QuestNPC/MarbleThrower/readme.md

Project for Principles of Digital Fabrication

Students: Aki Korpinen, Jaakko Astikainen, Eino Niemelä, Antti Jääski
