QuestNPC/MarbleThrower/2D files/Box out small.pdf

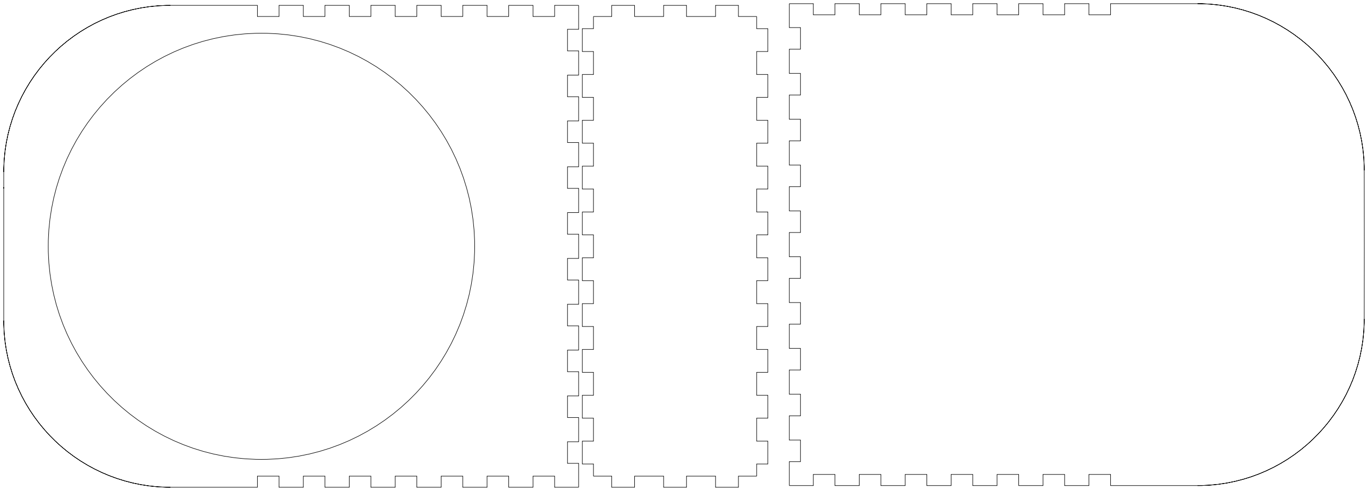
[picture p3: figure]
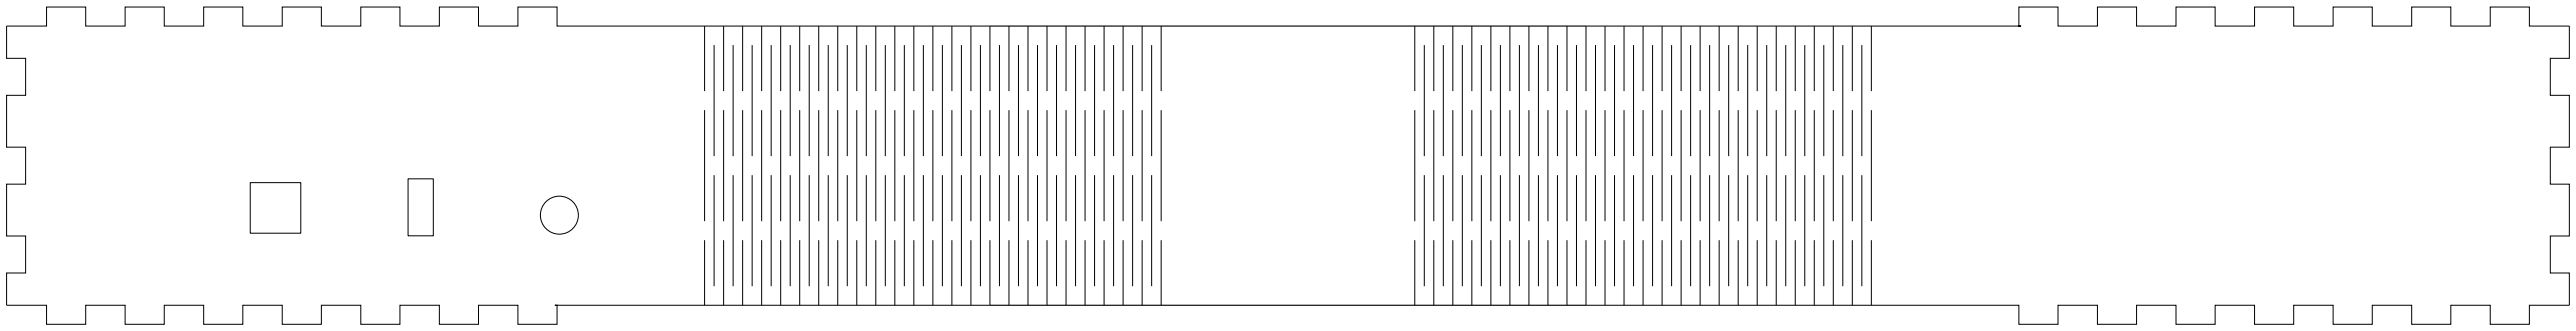
[picture p4: figure]
