QuestNPC/MarbleThrower/Documentation drafts/images/Final_overall.png

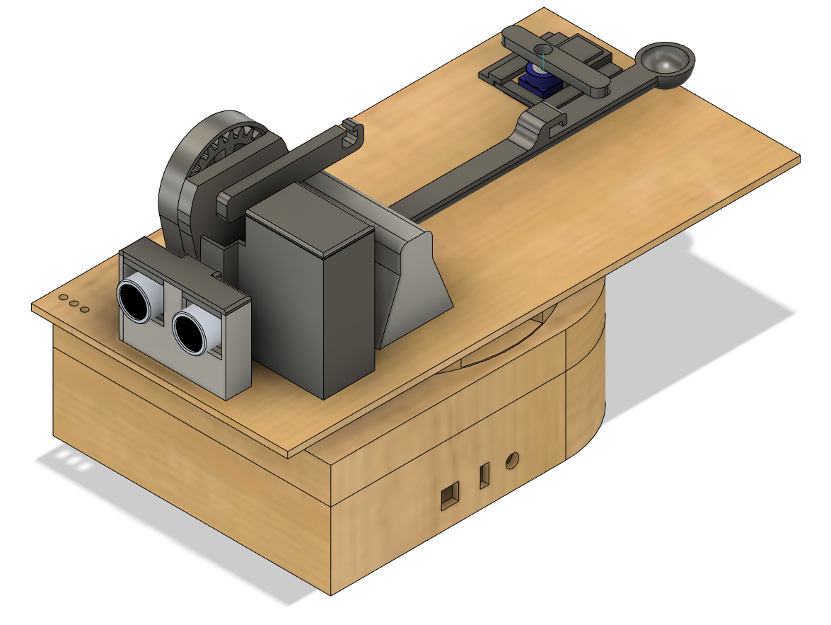
Documentation drafts/images/Final_overall.png
