QuestNPC/MarbleThrower/Documentation drafts/images/Final_side.png

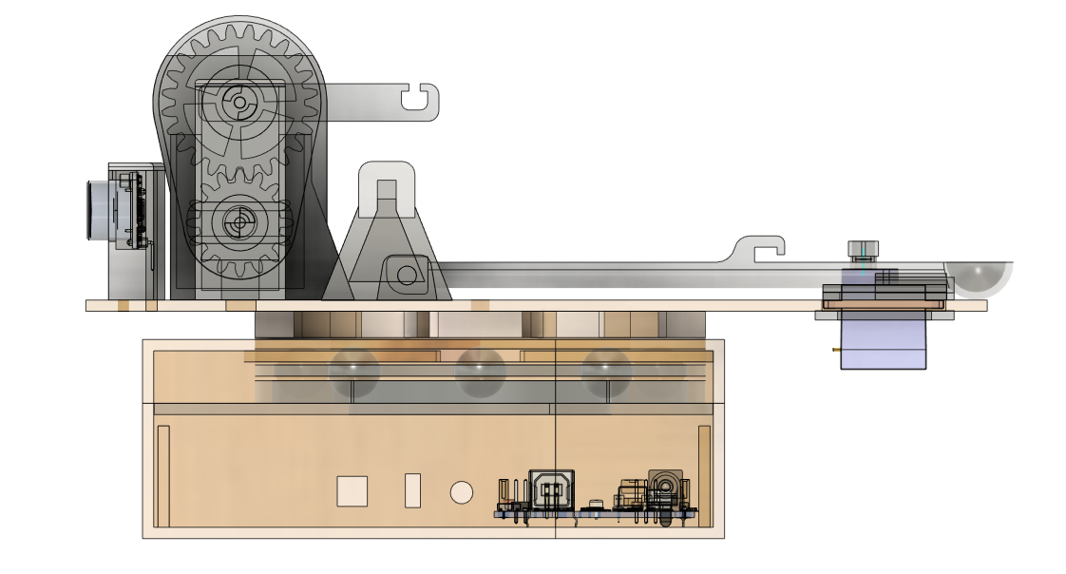
Documentation drafts/images/Final_side.png
