QuestNPC/MarbleThrower/Documentation drafts/Bill_of_Materials.md

* 1x Arduino Uno
* 1 x Ultrasonic sensor
* 2 x Micro Servo Motor SG90
* 1 x Servo motor HS-322HD
* 1 x Push micro button
* 3 x LEDs
* 1 x Potentiometer
* 1 x slide switch
* 1 x M4x40 bolt + nut
* Plywood
* marbles/glassballs (14mm diam)
