QuestNPC/MarbleThrower/3D files/Parts STL files/stopper.stl

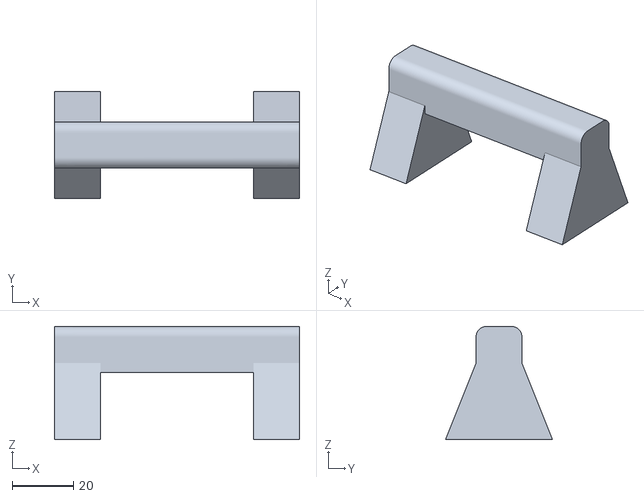
[picture p7: CAD file, 2021-05-05]
3D files/Parts STL files/stopper.stl
80.0 x 35.0 x 37.0
