QuestNPC/MarbleThrower/3D files/Parts STL files/servo-gear-connector-part2.stl

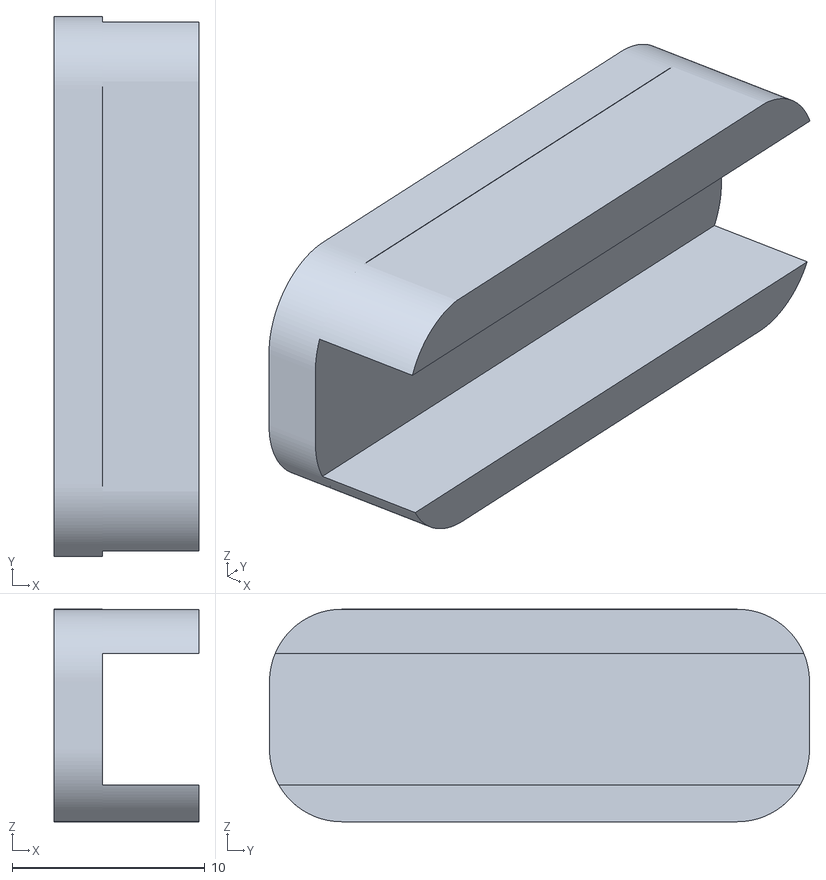
[picture p8: CAD file, 2021-05-05]
3D files/Parts STL files/servo-gear-connector-part2.stl
7.50 x 28.0 x 11.0
