QuestNPC/MarbleThrower/3D files/Parts STL files/Servo_holder_piece.stl

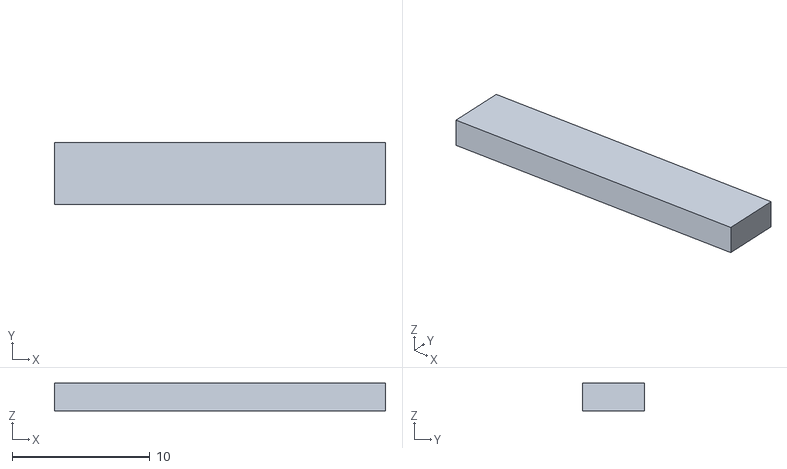
[picture p9: CAD file, 2021-05-05]
3D files/Parts STL files/Servo_holder_piece.stl
24.0 x 4.50 x 2.00
