QuestNPC/MarbleThrower/3D files/Parts STL files/Nobs.stl

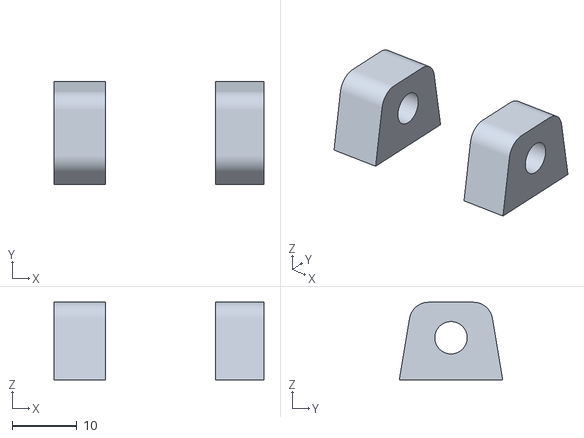
[picture p10: CAD file, 2021-05-05]
3D files/Parts STL files/Nobs.stl
32.5 x 16.0 x 12.0
