QuestNPC/MarbleThrower/3D files/Parts STL files/servo_holder_top.stl

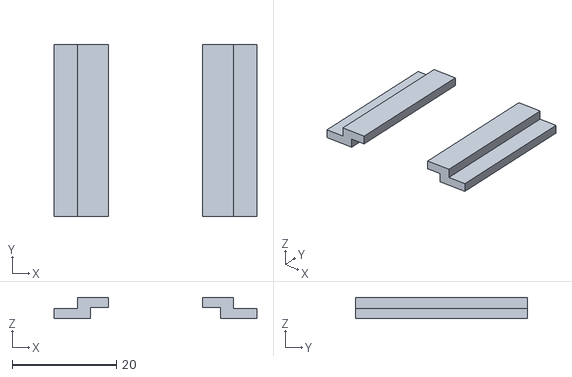
[picture p11: CAD file, 2021-05-05]
3D files/Parts STL files/servo_holder_top.stl
39.0 x 33.0 x 4.10
