QuestNPC/MarbleThrower/3D files/Parts STL files/Spur Gear (16 teeth).stl

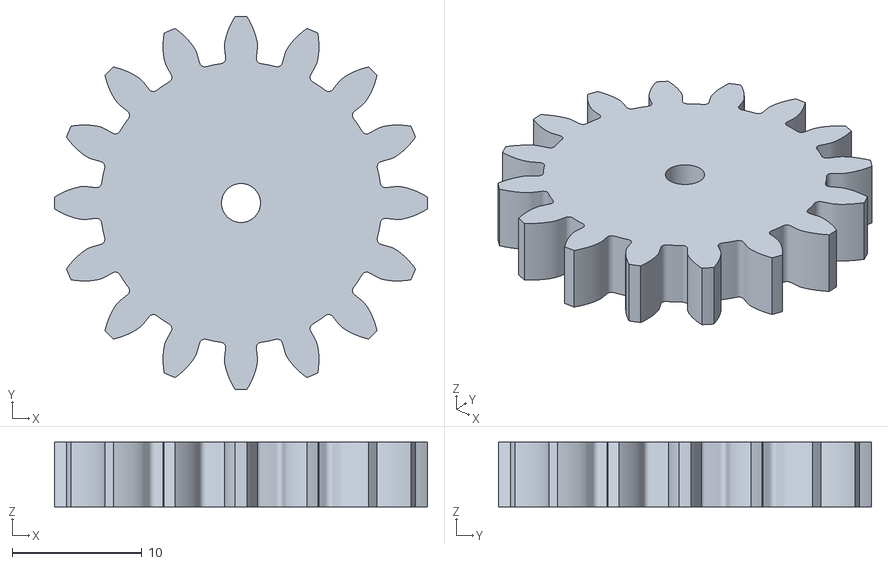
[picture p12: CAD file, 2021-05-05]
3D files/Parts STL files/Spur Gear (16 teeth).stl
28.7 x 28.7 x 5.00
