QuestNPC/MarbleThrower/3D files/Parts STL files/Lever.stl

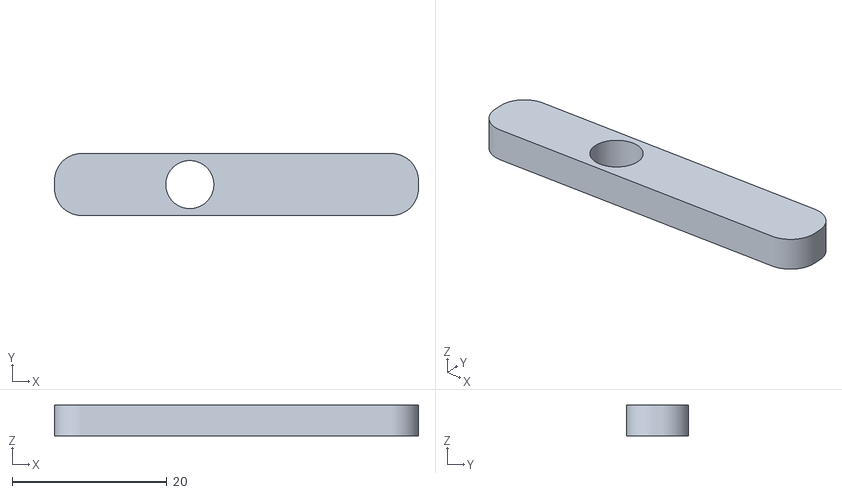
[picture p13: CAD file, 2021-05-05]
3D files/Parts STL files/Lever.stl
47.0 x 8.00 x 4.00
