QuestNPC/MarbleThrower/3D files/Parts STL files/ServoTower.stl

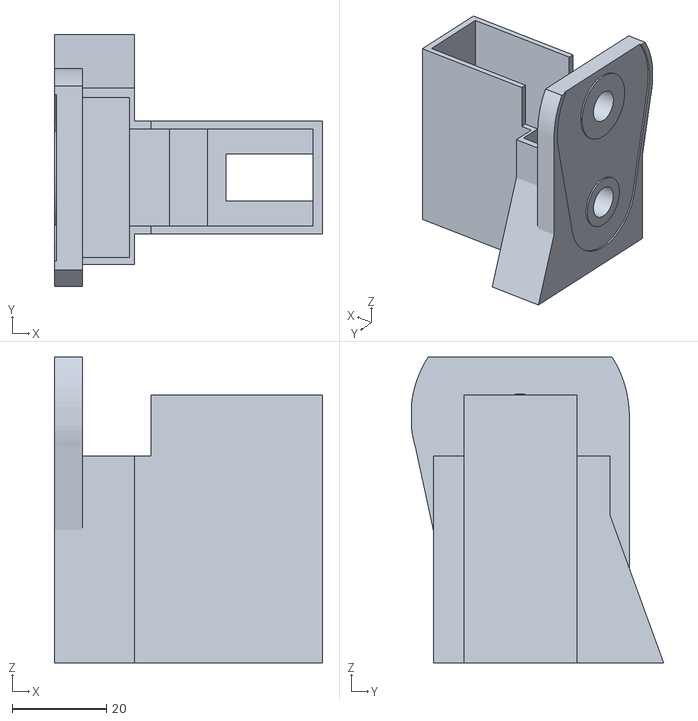
[picture p14: CAD file, 2021-05-05]
3D files/Parts STL files/ServoTower.stl
57.0 x 53.6 x 65.0
