QuestNPC/MarbleThrower/3D files/Parts STL files/Spur Gear (24 teeth).stl

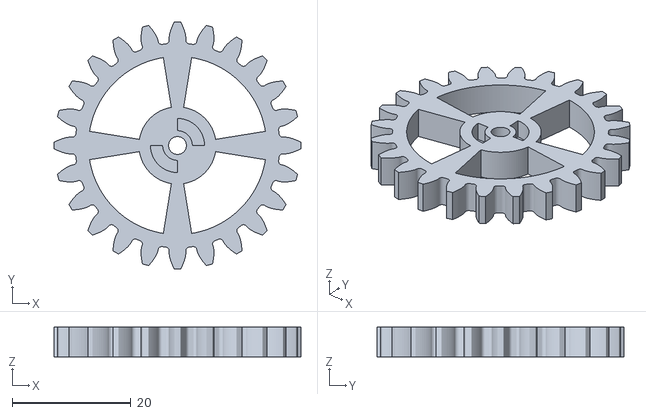
[picture p15: CAD file, 2021-05-05]
3D files/Parts STL files/Spur Gear (24 teeth).stl
41.6 x 41.6 x 5.00
