QuestNPC/MarbleThrower/3D files/Parts STL files/Servo_holder_bottom.stl

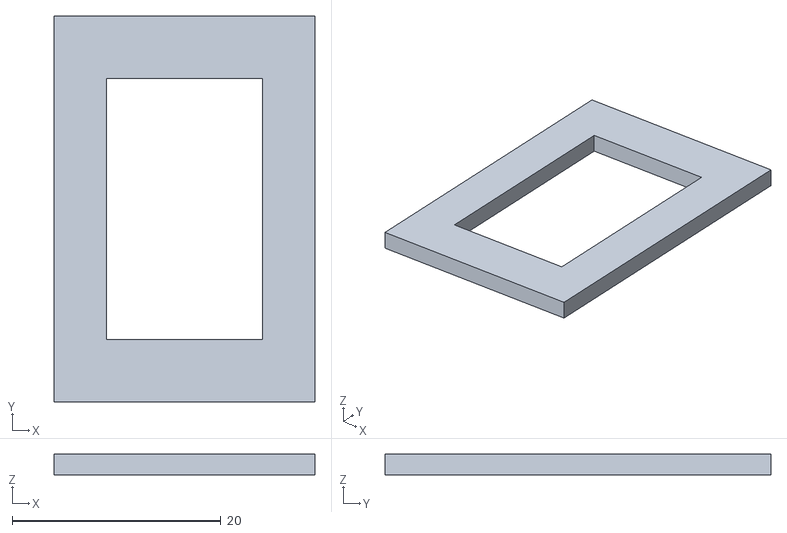
[picture p16: CAD file, 2021-05-05]
3D files/Parts STL files/Servo_holder_bottom.stl
25.0 x 37.0 x 2.00
