QuestNPC/MarbleThrower/3D files/Parts STL files/servo-gear-connector-part1.stl

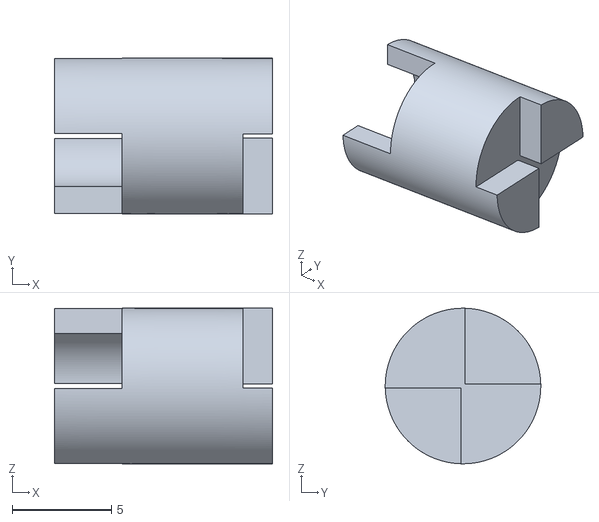
[picture p17: CAD file, 2021-05-05]
3D files/Parts STL files/servo-gear-connector-part1.stl
11.0 x 7.85 x 7.85
