QuestNPC/MarbleThrower/3D files/Parts STL files/Servo_cover.stl

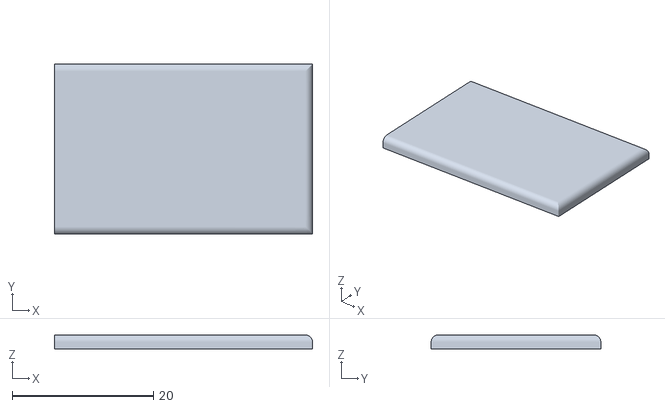
[picture p18: CAD file, 2021-05-05]
3D files/Parts STL files/Servo_cover.stl
36.5 x 24.0 x 2.00
