QuestNPC/MarbleThrower/3D files/Parts STL files/Servo_holder_top2.stl

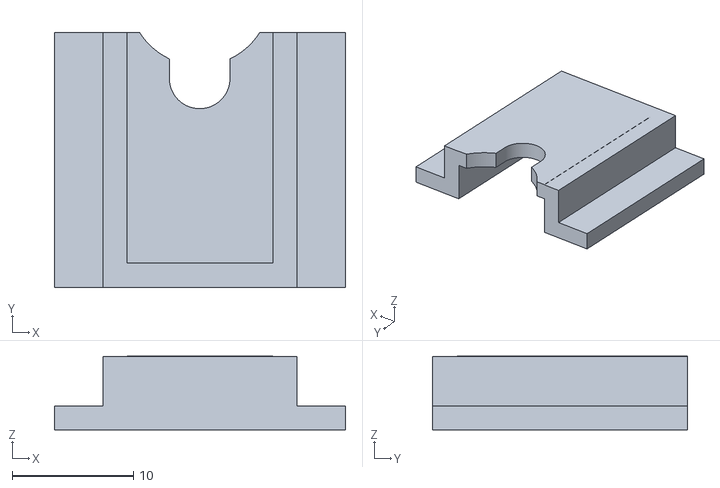
[picture p19: CAD file, 2021-05-05]
3D files/Parts STL files/Servo_holder_top2.stl
24.0 x 21.0 x 6.08
