QuestNPC/MarbleThrower/3D files/Parts STL files/Gearcage.stl

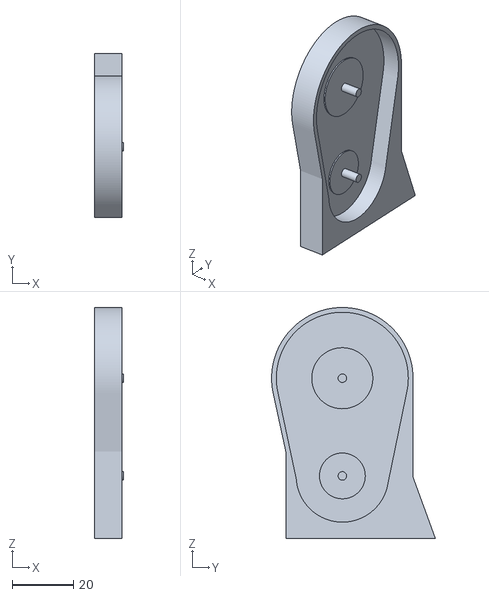
[picture p20: CAD file, 2021-05-05]
3D files/Parts STL files/Gearcage.stl
9.50 x 53.7 x 75.7
