QuestNPC/MarbleThrower/3D files/Parts STL files/Ultra_cover.stl

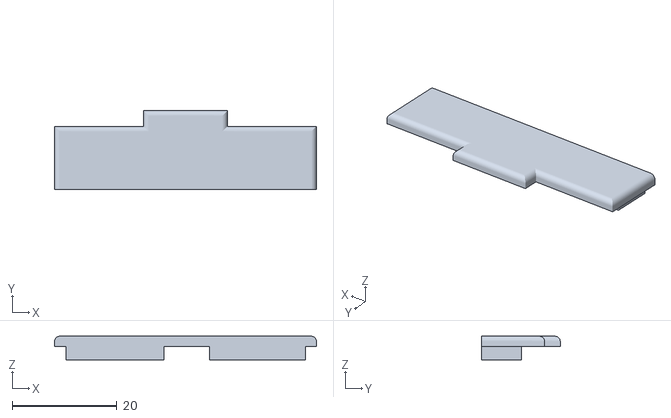
[picture p21: CAD file, 2021-04-27]
3D files/Parts STL files/Ultra_cover.stl
50.0 x 15.0 x 4.50
