QuestNPC/MarbleThrower/3D files/Parts STL files/Ultra.stl

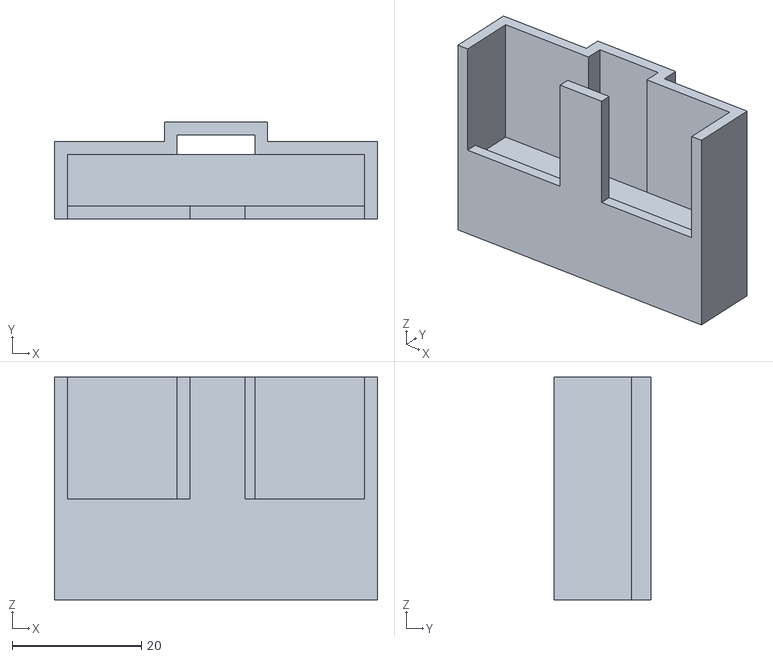
[picture p22: CAD file, 2021-04-21]
3D files/Parts STL files/Ultra.stl
50.0 x 15.0 x 34.5
