QuestNPC/MarbleThrower/3D files/Parts STL files/Arm.stl

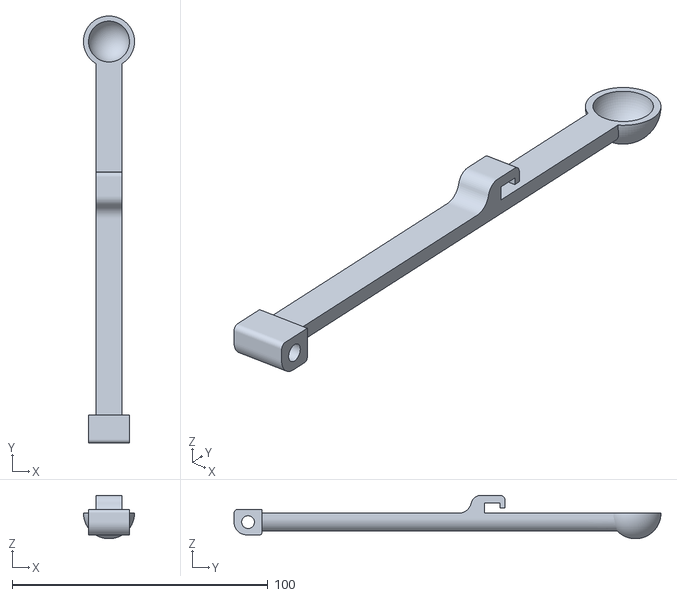
[picture p23: CAD file, 2021-04-21]
3D files/Parts STL files/Arm.stl
20.0 x 167.0 x 17.0
