QuestNPC/MarbleThrower/3D files/Parts STL files/Tensioning_arm.stl

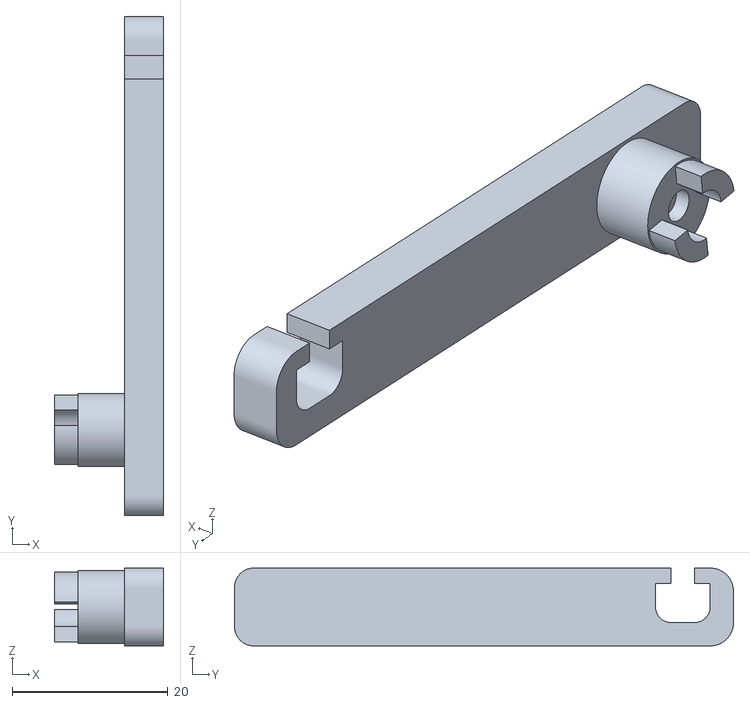
[picture p24: CAD file, 2021-04-21]
3D files/Parts STL files/Tensioning_arm.stl
14.0 x 64.0 x 10.0
