QuestNPC/MarbleThrower/2D files/Platform.pdf

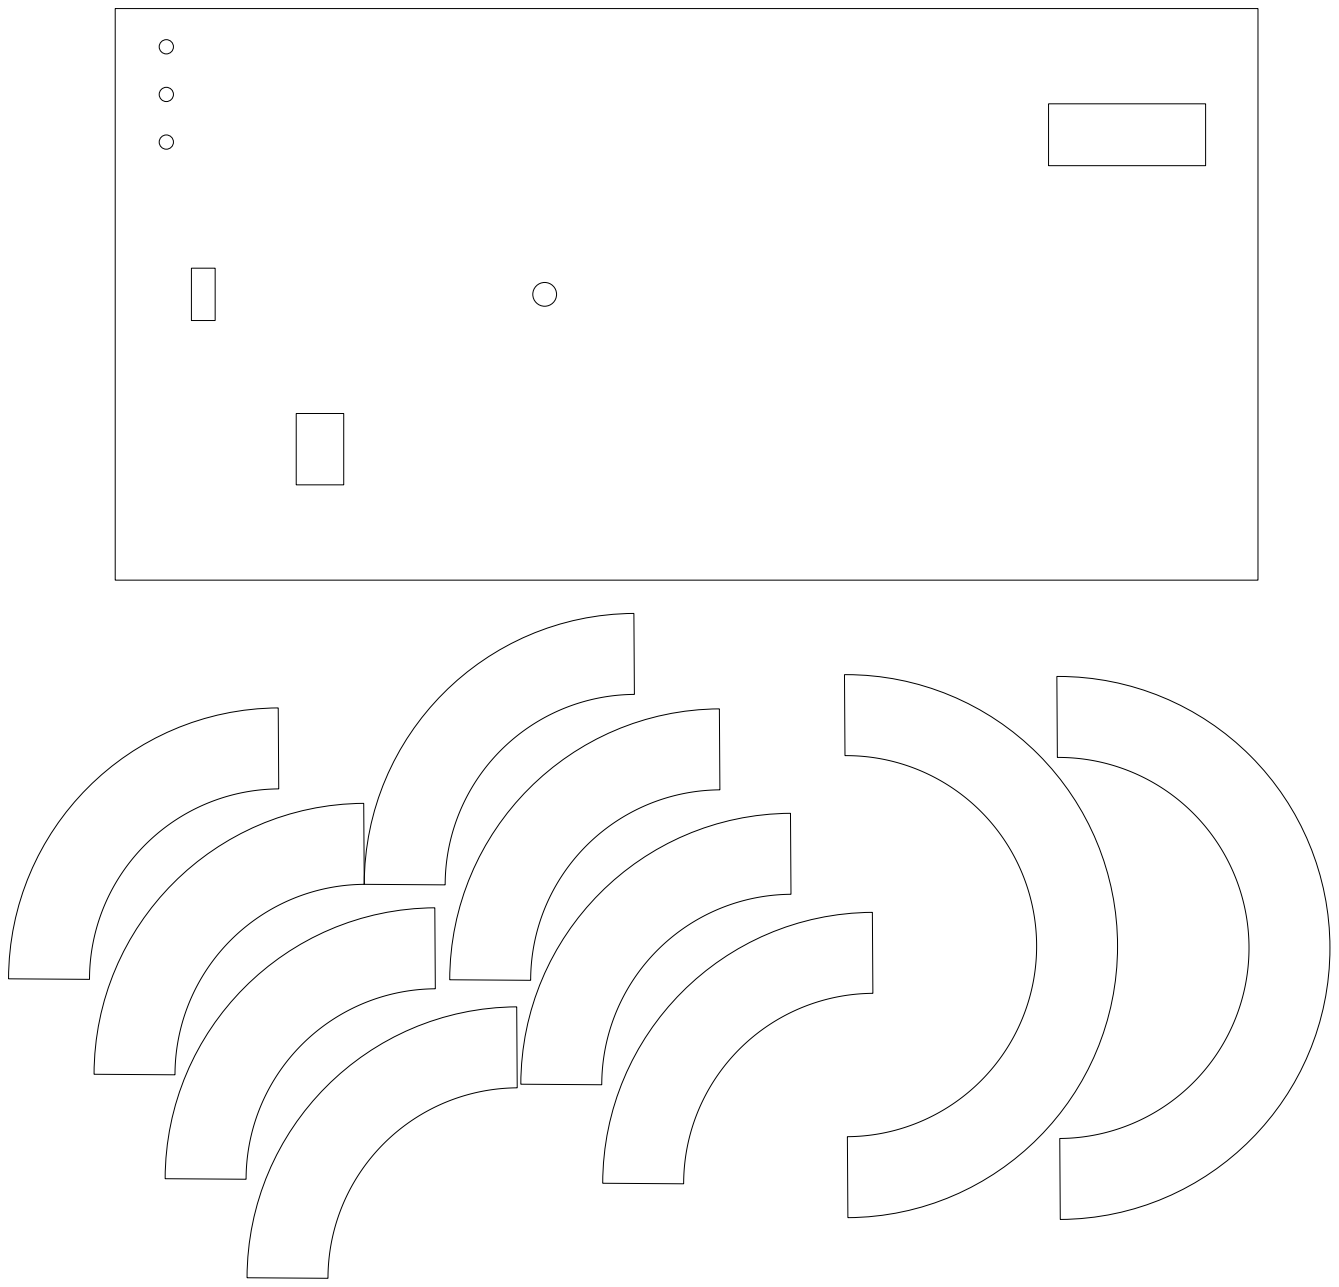
[picture p36: page 1]
