QuestNPC/MarbleThrower/2D files/Box Inside small.pdf

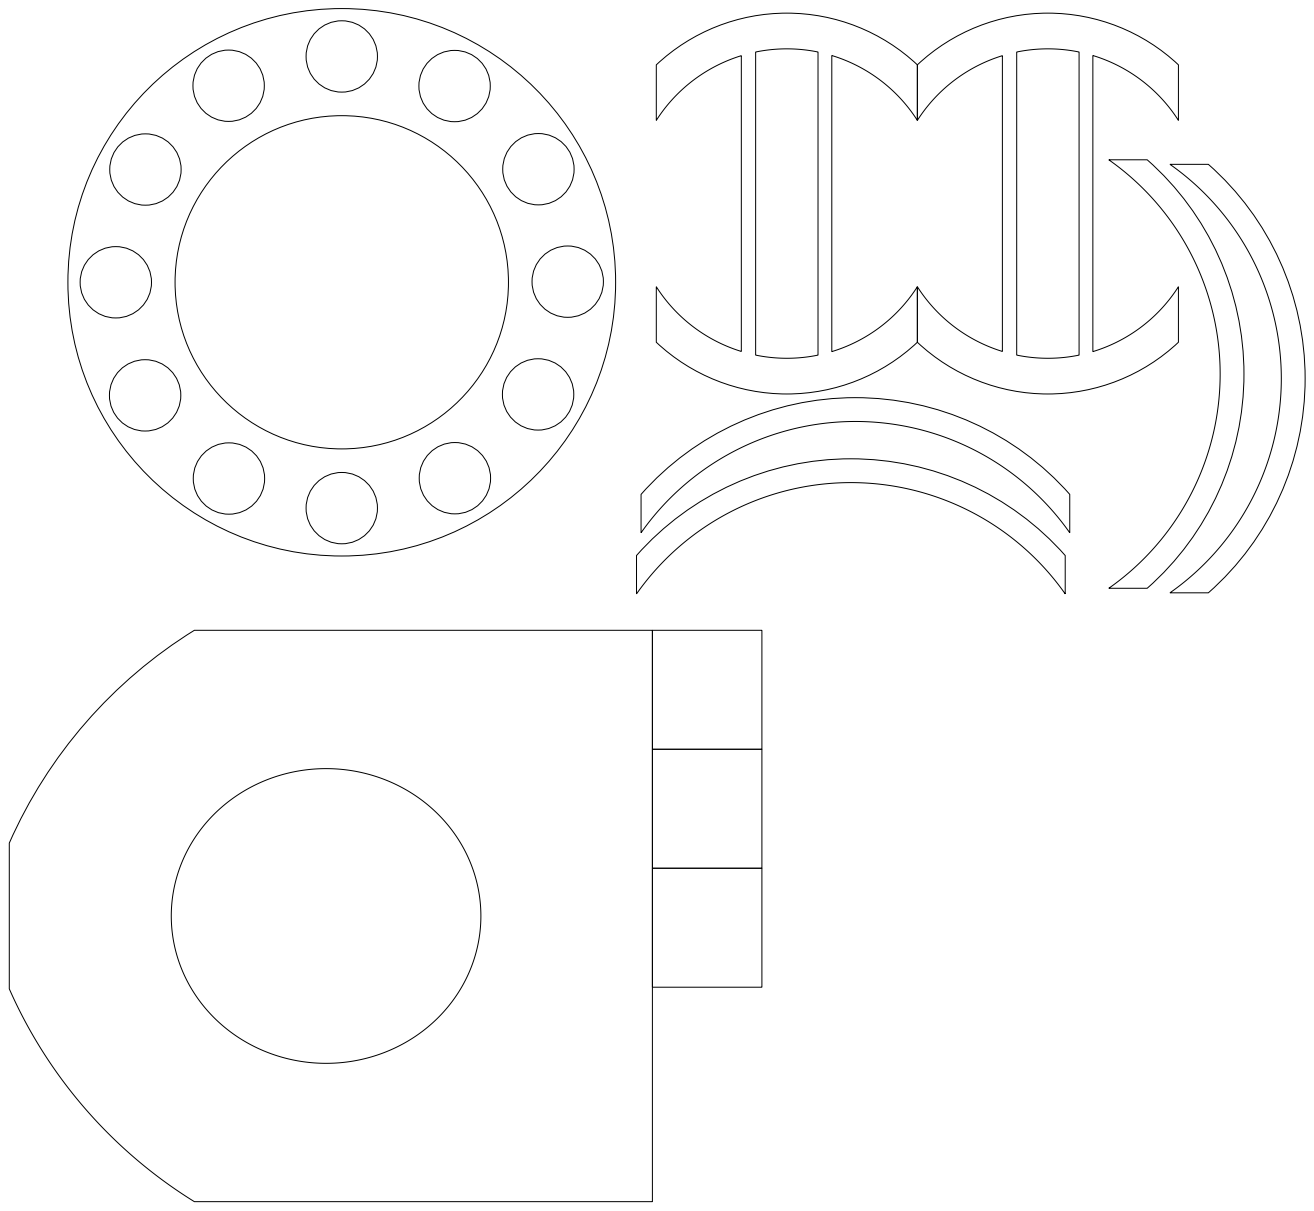
[picture p37: page 1]
