QuestNPC/MarbleThrower/(commit log)

2021-03-27 Update introductory_report.md
    bill of materials update
2021-03-30 Create Heittokone v3.f3d
    3D mallinnuksen aloittelua, varren tekele kokeiltu tehä
    [Heittokone v3.f3d]
2021-04-02 3d modeling update
    [Heittokone v3.f3d, Heittokone v6.f3d, Heittokone v6.stl]
2021-04-02 Create Circuit design and code
2021-04-02 Update Circuit design and code
2021-04-04 3d update
    [Heittokone v6.f3d, Heittokone v6.stl, Heittokone v8.f3d, Heittokone v8.stl]
2021-04-13 3d File update
    [Heittokone v8.f3d, Heittokone v8.stl]
2021-04-21 STL files
    [Gearcage.stl, ServoTower.stl, Servo_cover.stl, Servo_hold_bottom.stl, Servo_hold_piece.stl, Spur Gear (16 teeth).stl, Spur Gear (24 teeth).stl, Ultra (1).stl]
2021-04-25 STL update
    [Spur Gear (16 teeth).stl, servo-gear-connector-part1.stl, servo-gear-connector-part2.stl]
2021-04-25 bigger servo STLs
    [Servo_cover_bigger.stl, Servo_tower_bigger.stl]
2021-04-29 Create Heittokone_ServoTower_bigger v4.stl
    [Heittokone_ServoTower_bigger v4.stl]
2021-05-04 .eps files
    Created .eps files for laser cutting as the inkscape laser cutting tutorial suggests.
2021-05-05 Files
    Hopefully last model update
    [Gearcage.stl, Heittokone_ServoTower_bigger v4.stl, Heittokone_ServoTower_bigger v9.stl, Heittokone_Servo_cover_bigger v2 v2.stl, ServoTower.stl, Servo_cover.stl, Servo_cover_bigger.stl, Servo_hold_bottom.stl]
2021-05-05 File updates
    [Arm.stl, Gearcage.stl, Lever.stl, Nobs.stl, ServoTower.stl, Servo_cover.stl, Servo_holder_bottom.stl, Servo_holder_piece.stl]
